lorenz-graf/toh-devkit/model/ctohm-bump.stl

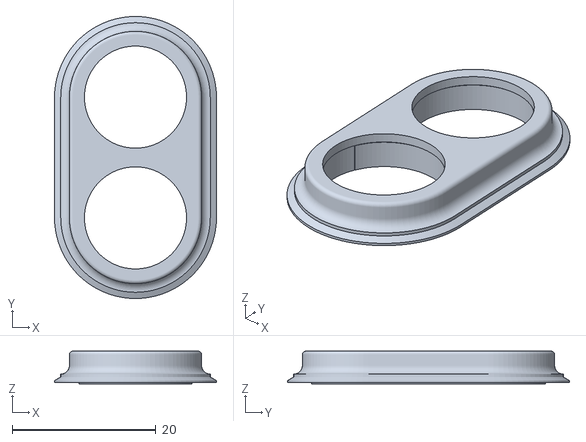
[picture p6: CAD file, 2026-11-07]
model/ctohm-bump.stl
22.5 x 39.2 x 4.56
