lorenz-graf/toh-devkit/model/ctohm-dev.step

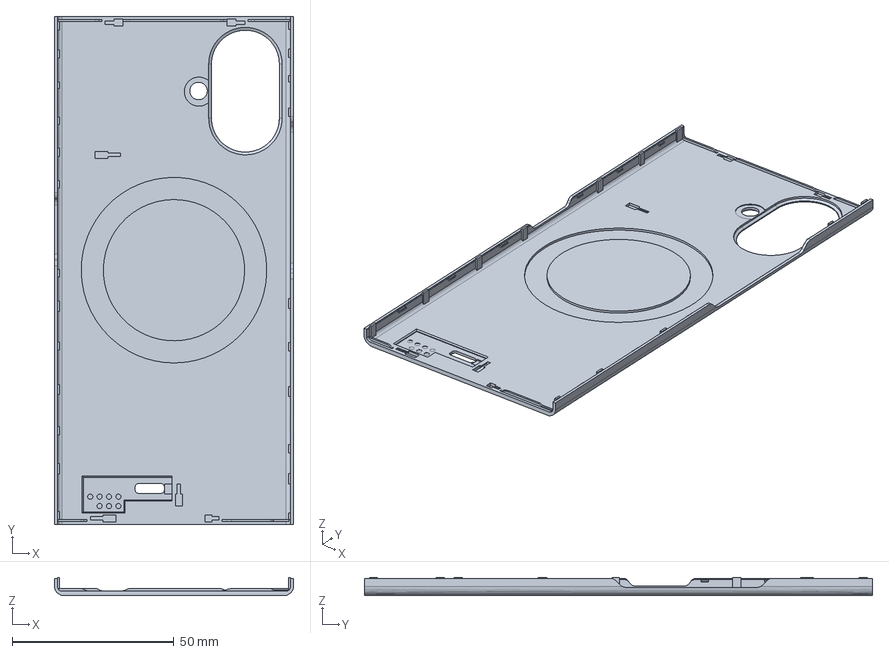
[picture p7: CAD file, 2026-11-07]
model/ctohm-dev.step
74.0 x 157.2 x 5.71 mm
