lorenz-graf/toh-devkit/(list of files, cad)

Other CAD files:
model/ctohm-dev.stl
