lorenz-graf/toh-devkit/pcb/breakout/dev-toh-breakout.kicad_pcb

## KiCad design pcb/breakout/dev-toh-breakout.kicad_pcb (2026-11-07)

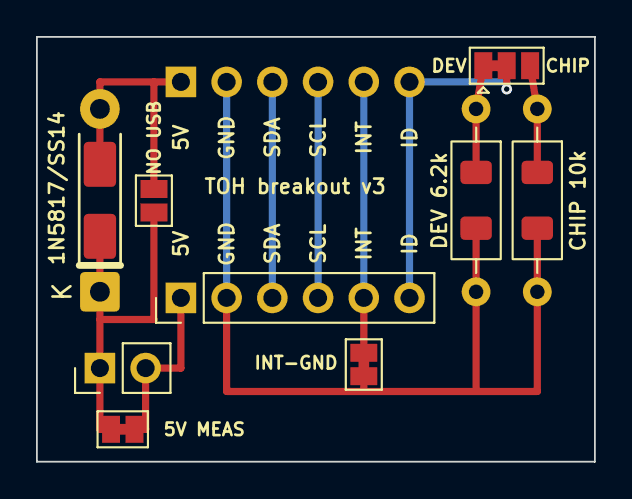
[picture p8: board dev-toh-breakout.kicad_pcb from above]

Board: 2 copper layers, 31.0 x 23.6 mm, 13 parts (0 on the bottom side), 10 nets.

Parts:
D1: D_DO-41_SOD81_P10.16mm_Horizontal
D1S: D_SMA
J1, J2: PinHeader_1x06_P2.54mm_Vertical
J3: PinHeader_1x02_P2.54mm_Vertical
JP1, JP4: SolderJumper-2_P1.3mm_Bridged_Pad1.0x1.5mm
JP2: SolderJumper-3_P1.3mm_Bridged12_Pad1.0x1.5mm
JP3: SolderJumper-2_P1.3mm_Open_Pad1.0x1.5mm
R1, R2: R_Axial_DIN0207_L6.3mm_D2.5mm_P10.16mm_Horizontal
R1S, R2S: R_1206_3216Metric_Pad1.30x1.75mm_HandSolder

Connections:
5V: J2.1, J3.2, JP4.2
5V_D: D1.1, D1S.1, J3.1, JP3.2, JP4.1
5V_PHONE: D1.2, D1S.2, J1.1, JP3.1
GND: J1.2, J2.2, JP1.2, R1.2, R1S.2, R2.2, R2S.2
ID: J1.6, J2.6, JP2.2
ID_A: JP2.1, R1.1, R1S.1
ID_B: JP2.3, R2.1, R2S.1
INT: J1.5, J2.5, JP1.1
SCL: J1.4, J2.4
SDA: J1.3, J2.3
