lorenz-graf/toh-devkit/(commit log)

2026-11-07 TOH DevKit: breadboard dev cover for the Jolla Phone 2026
    First public version, not yet built or tested on hardware:
    - cTOH-M frame with a wire slot through its contact-board indent, laid
    flat for printing, plus the camera bump with supports reaching the bed
    - contact board v2 (0.6 mm, ENIG, 1 A power lines) and breakout board v2
    (DEV/CHIP ID jumper, INT-GND, USB backfeed diode, 5 V measure point,
    diode bypass), generated by KiCad Python scripts, with ordered Gerbers
    - README with pinout, jumpers, printing, assembly, first test and
    troubleshooting; ID-modes.md on the 6.2 kOhm vs 10 kOhm modes
    - BSD-3-Clause (models derived from sailfishos/toh-designs)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
    [ctohm-bump.stl, ctohm-dev.step, ctohm-dev.stl, dev-toh-breakout.kicad_pcb, dev-toh-contact.kicad_pcb]
2026-11-07 README: mark untested assumptions, explain solder jumpers
    Nothing is built yet, so claims about how the phone reacts, the need for
    the Schottky diode, symbiosis' INT handling and the positioning accuracy
    are now phrased as expectations. Adds how to open and close the solder
    jumpers, and more on the diode's voltage drop and when to use NO USB.
2026-11-07 Breakout v3: SMD footprints in parallel to D1, R1, R2
    SMA (e.g. SS14) and 1206 pads between the through-hole pads, so either
    part can be fitted. Not manufactured yet; the ordered v2 Gerbers are kept
    as dev-toh-breakout-v2-gerbers-ordered.zip.
    [dev-toh-breakout.kicad_pcb]
